eedede/treckr/schematic/treckr_hw_pic.jpg

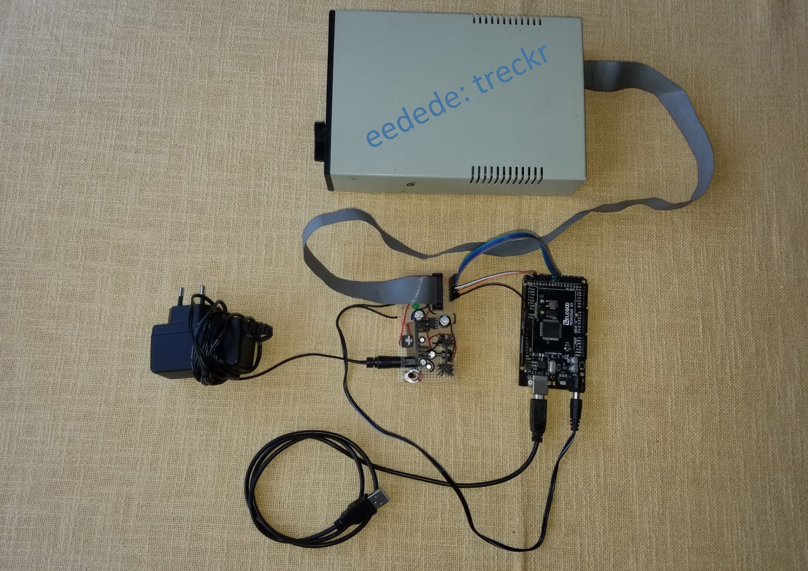
schematic/treckr_hw_pic.jpg
