eedede/treckr/schematic/treckr_schematic.pdf

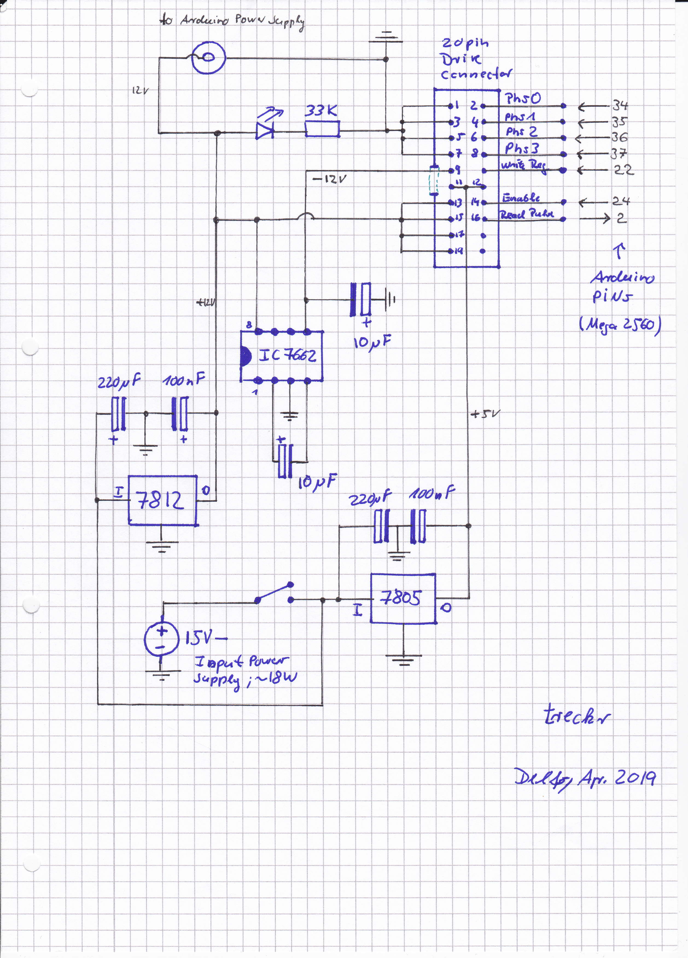
[picture p2: page 1]
