eedede/treckr/schematic/treckr_schematic.jpg

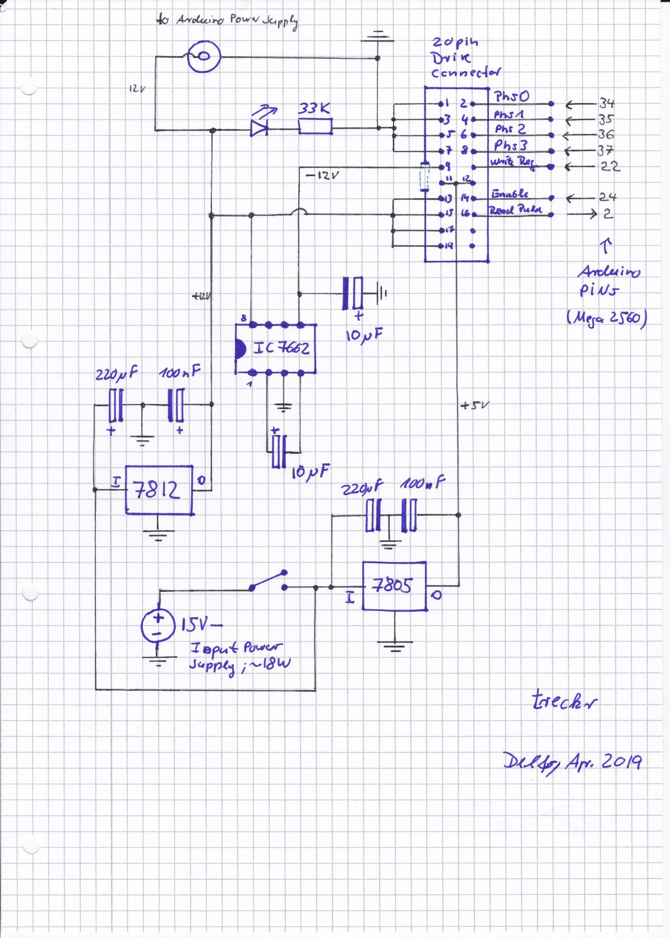
schematic/treckr_schematic.jpg
